m-guihard/biorob_project/README.md

# Design and characterization of a bio-inspired multi-segmented leg consisting of spring and tendon
Contains all files related to the project
