m-guihard/biorob_project/code/README.md

# Running the simulations
All simulations are run from the file 'run.py'. After choosing between the single leg or full quadruped, the options available can be changed.
