m-guihard/biorob_project/CAD/_hip_module.SLDASM

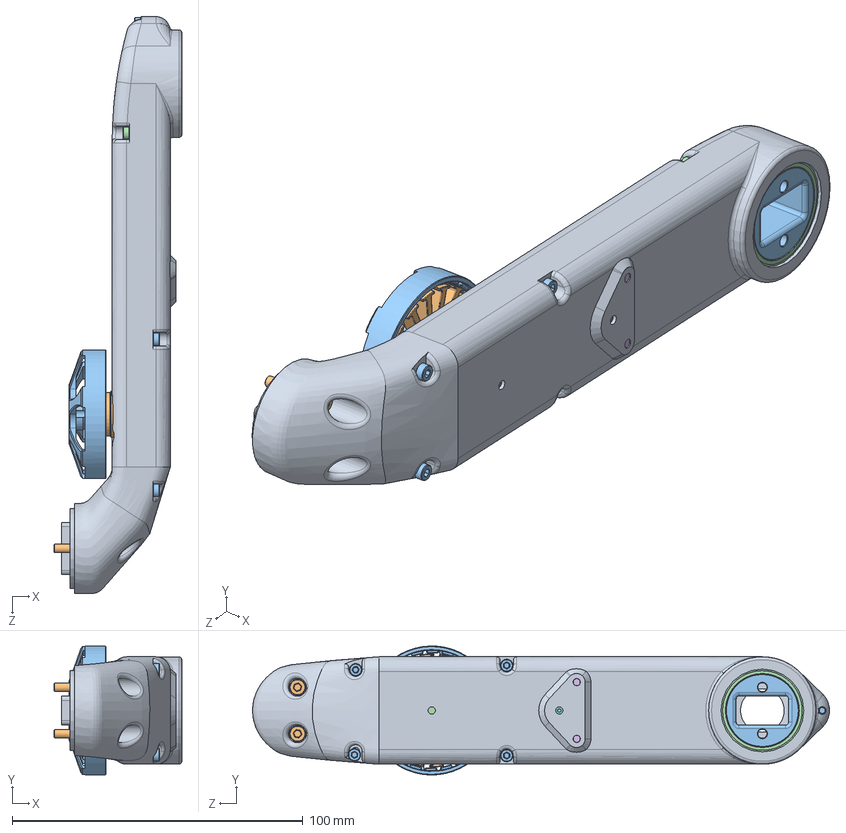
[picture p24: CAD file, 2022-06-10]
CAD/_hip_module.SLDASM
44.0 x 44.4 x 198.6 mm
hip_module_shell
motor_antigravity_4004_stator
motor_antigravity_4004_rotor
motor_antigravity_4004_custom_shaft
motor_antigravity_4004_brass_spacer
transmission_pulley_at3_t10_motor
encoder_codewheel_pwb_mount
encoder_codewheel_5000cpr_pwb_7mm
bearing_8_4_2_sbn_MR84VA x 3
fastener_fhs_m3_5 x 4
transmission_pulley_at3_t30_output
bearing_32_25_4_sbn_61705RS x 2
encoder_avago_aedt_9810
fastener_fhs_m3_16_plastic x 2
transmission_timing_belt_at3_150_4
transmission_pulley_at3_t10_center
transmission_pulley_at3_t30_center
fastener_shcs_m3_16 x 2
fastener_shcs_m2.5_6 x 5
fastener_shcs_m2.5_10 x 3
bearing_7_3_3_sbn_683_2ZVA x 2
fastener_fhs_m3_10 x 2
fastener_washer_m2.5 x 2
transmission_belt_tensioner_roller x 2
transmission_timing_belt_at3_201_6
