m-guihard/biorob_project/CAD/simple_design/_body_structure.SLDASM

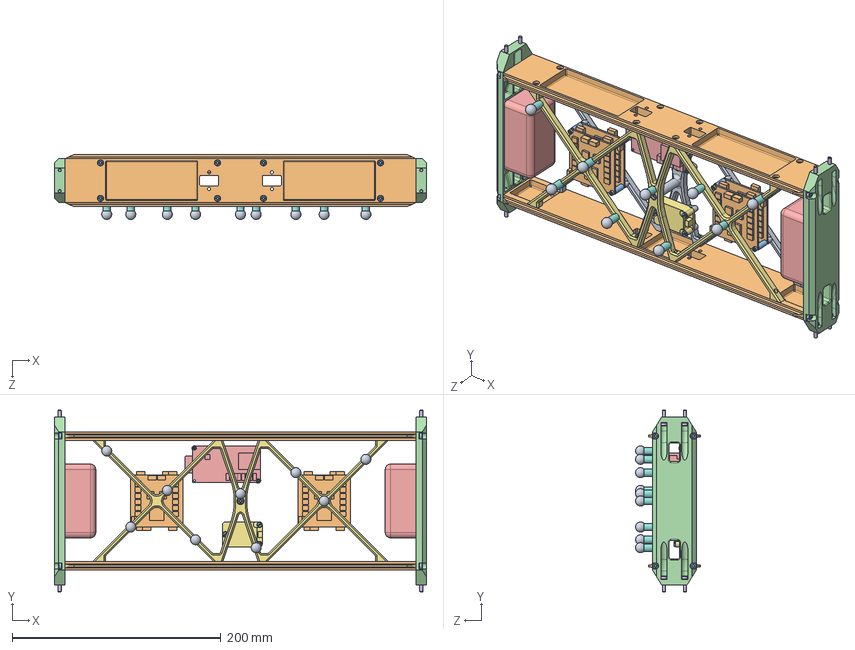
[picture p26: CAD file, 2022-06-10]
CAD/simple_design/_body_structure.SLDASM
356.0 x 174.0 x 62.2 mm
body_structure_bottom
body_structure_side x 2
fastener_shcs_m3_8 x 26
body_structure_front x 2
battery_placeholder x 2
fastener_shcs_m3_12 x 8
body_structure_top
body_structure_top_vicon
vicon_marker_10mm x 9
micro_driver_90_deg_hirose x 4
spacer_micro_driver_stack_12mm x 8
fastener_shcs_m2.5_20 x 8
master_board
fastener_shcs_m2_6 x 3
imu_3dm_cx5_25
fastener_shs_m2.5_12 x 3
