m-guihard/biorob_project/CAD/simple_design/front_right_leg.SLDASM

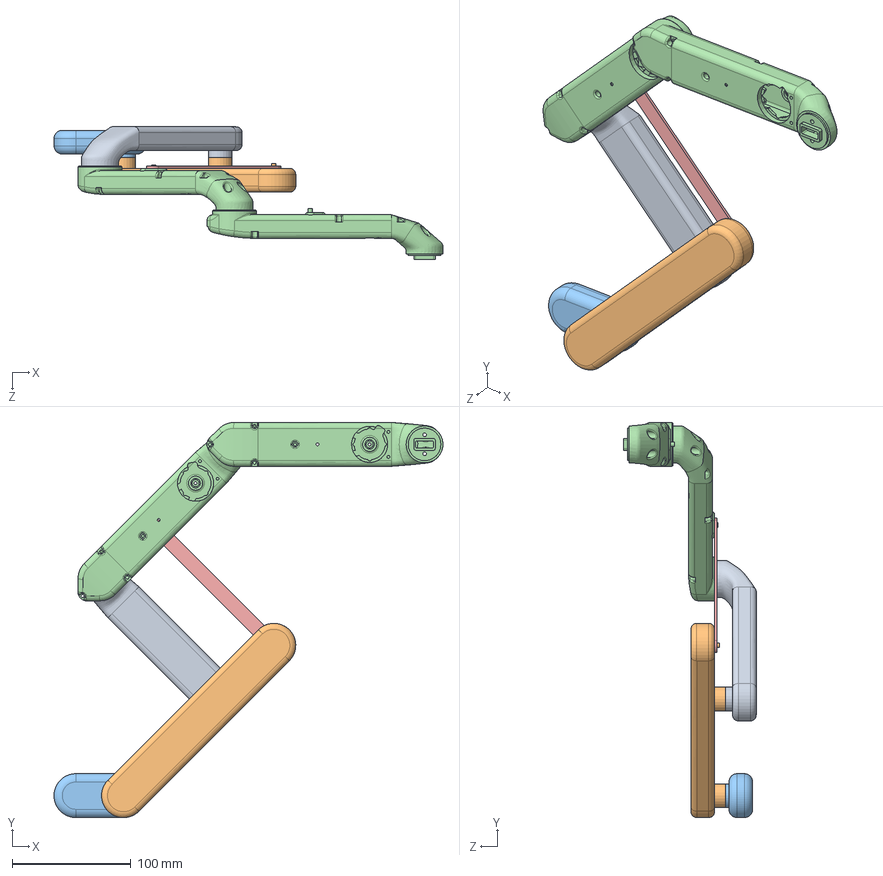
[picture p27: CAD file, 2022-06-10]
CAD/simple_design/front_right_leg.SLDASM
327.3 x 332.6 x 111.5 mm
calf_new
foot_new
toe
upper_leg_module_shell x 2
rod_full
