m-guihard/biorob_project/CAD/simple_design/rod_full.SLDPRT

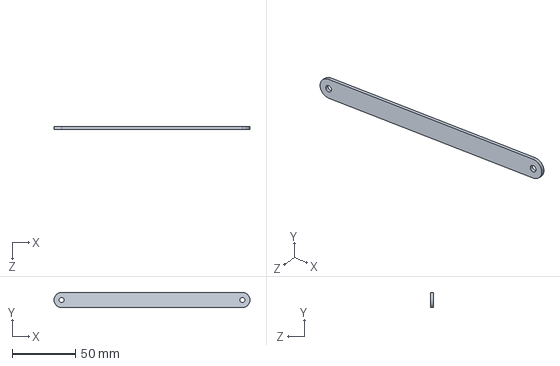
[picture p28: CAD file, 2022-06-10]
CAD/simple_design/rod_full.SLDPRT
155.0 x 12.0 x 2.00 mm
