m-guihard/biorob_project/CAD/simple_design/back_left_leg.SLDASM

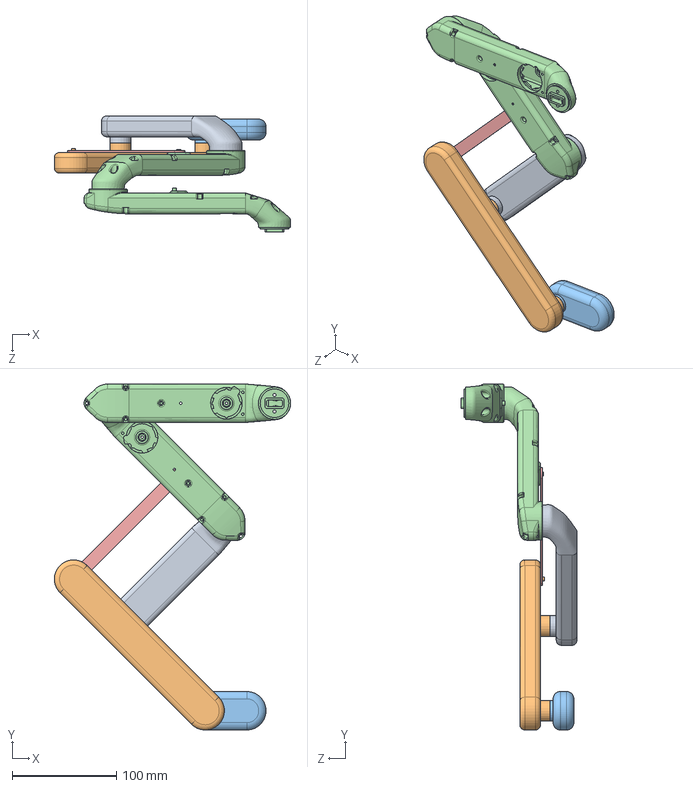
[picture p29: CAD file, 2022-06-10]
CAD/simple_design/back_left_leg.SLDASM
227.1 x 332.6 x 111.5 mm
calf_new
foot_new
toe
upper_leg_module_shell x 2
rod_full
