m-guihard/biorob_project/CAD/detailed_design/assembly.SLDASM

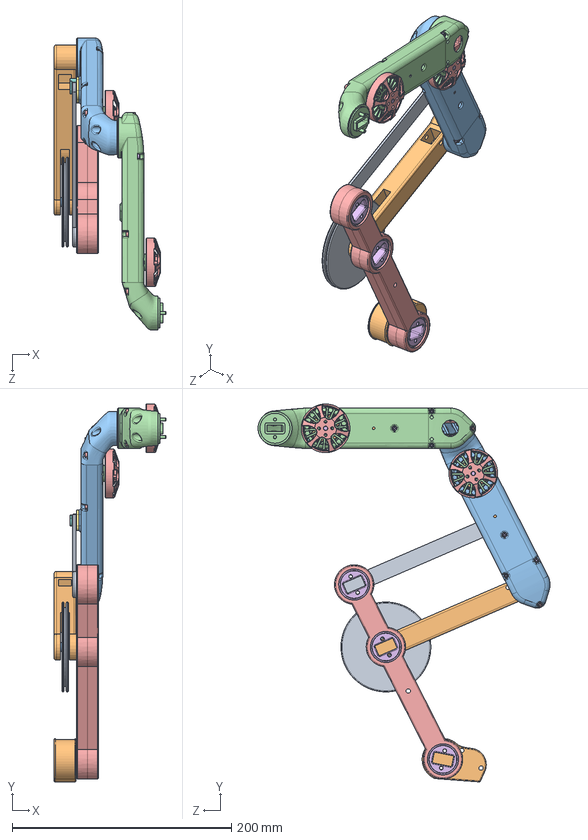
[picture p30: CAD file, 2022-06-10]
CAD/detailed_design/assembly.SLDASM
101.9 x 344.9 x 266.4 mm
pulley_knee
calf
upper_leg_module_shell
motor_antigravity_4004_stator x 2
motor_antigravity_4004_rotor x 2
motor_antigravity_4004_custom_shaft x 2
motor_antigravity_4004_brass_spacer x 2
transmission_pulley_at3_t10_motor x 2
encoder_codewheel_pwb_mount x 2
encoder_codewheel_5000cpr_pwb_7mm x 2
bearing_8_4_2_sbn_MR84VA x 6
fastener_fhs_m3_5 x 8
transmission_pulley_at3_t30_output x 2
bearing_32_25_4_sbn_61705RS x 8
encoder_avago_aedt_9810 x 2
fastener_fhs_m3_16_plastic x 4
transmission_timing_belt_at3_150_4 x 2
transmission_pulley_at3_t10_center x 2
transmission_pulley_at3_t30_center x 2
fastener_shcs_m3_16 x 4
fastener_shcs_m2.5_6 x 10
fastener_shcs_m2.5_10 x 6
bearing_7_3_3_sbn_683_2ZVA x 4
fastener_fhs_m3_10 x 4
fastener_washer_m2.5 x 4
transmission_belt_tensioner_roller x 4
transmission_timing_belt_at3_201_6 x 2
hip_module_shell
foot x 2
rotor x 3
support_bot
support_top
rod
toe
pin_knee_pulley
