m-guihard/biorob_project/CAD/detailed_design/calf.SLDPRT

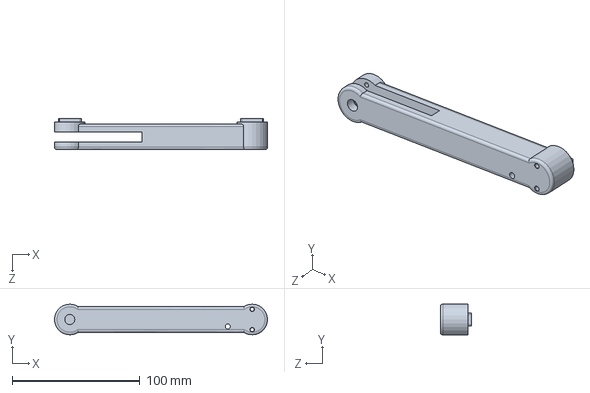
[picture p31: CAD file, 2022-06-10]
CAD/detailed_design/calf.SLDPRT
167.0 x 24.0 x 24.5 mm
