m-guihard/biorob_project/CAD/simple_design/foot_new.SLDPRT

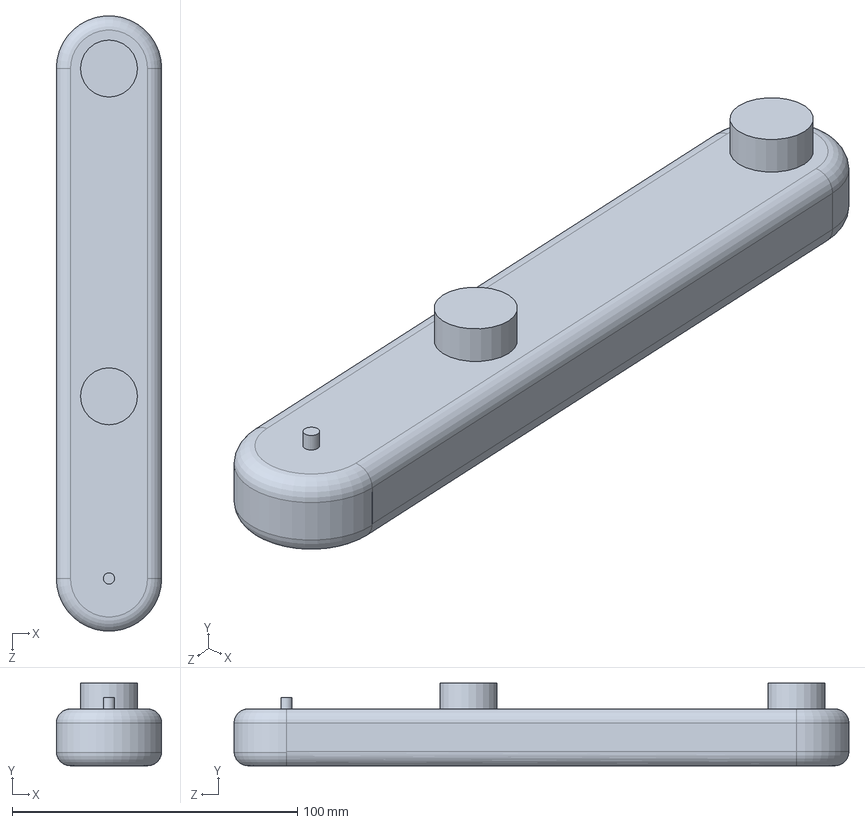
[picture p32: CAD file, 2022-06-10]
CAD/simple_design/foot_new.SLDPRT
37.0 x 29.0 x 215.8 mm
