m-guihard/biorob_project/code/models/biorob_full/meshes/BL_thigh.STL

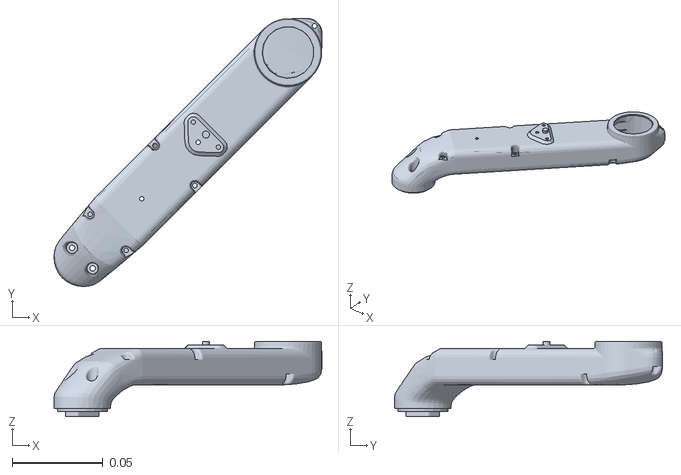
[picture p33: CAD file, 2022-06-10]
code/models/biorob_full/meshes/BL_thigh.STL
0.147 x 0.147 x 0.0415
