m-guihard/biorob_project/code/models/biorob_single/meshes/foot.STL

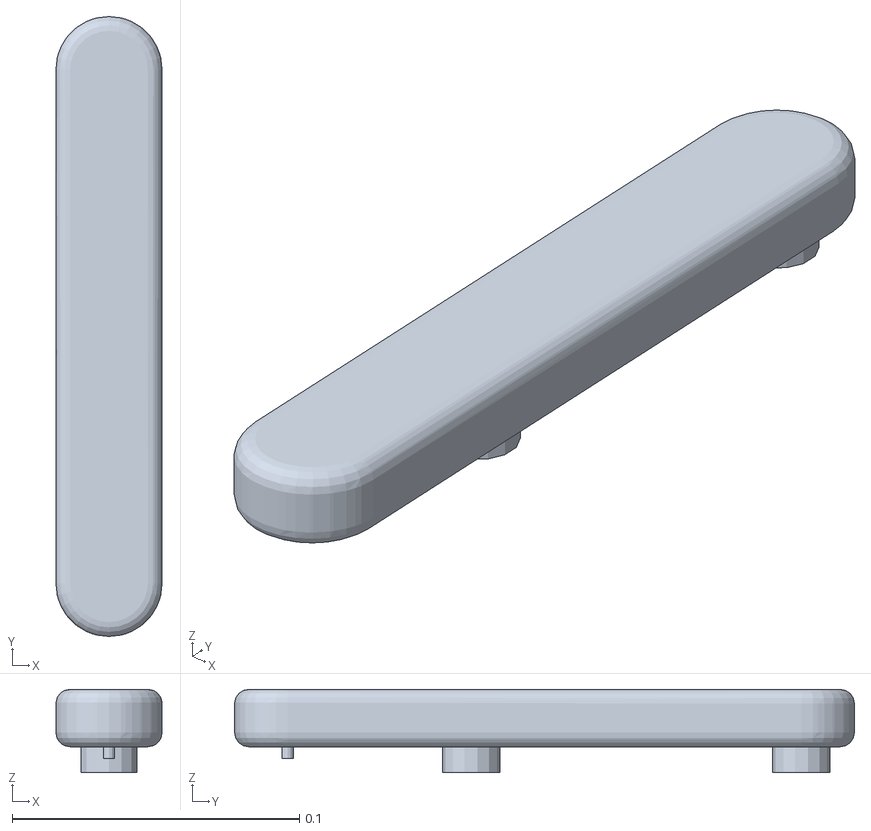
[picture p34: CAD file, 2022-06-10]
code/models/biorob_single/meshes/foot.STL
0.037 x 0.216 x 0.029
