m-guihard/biorob_project/CAD/detailed_design/rotor.SLDPRT

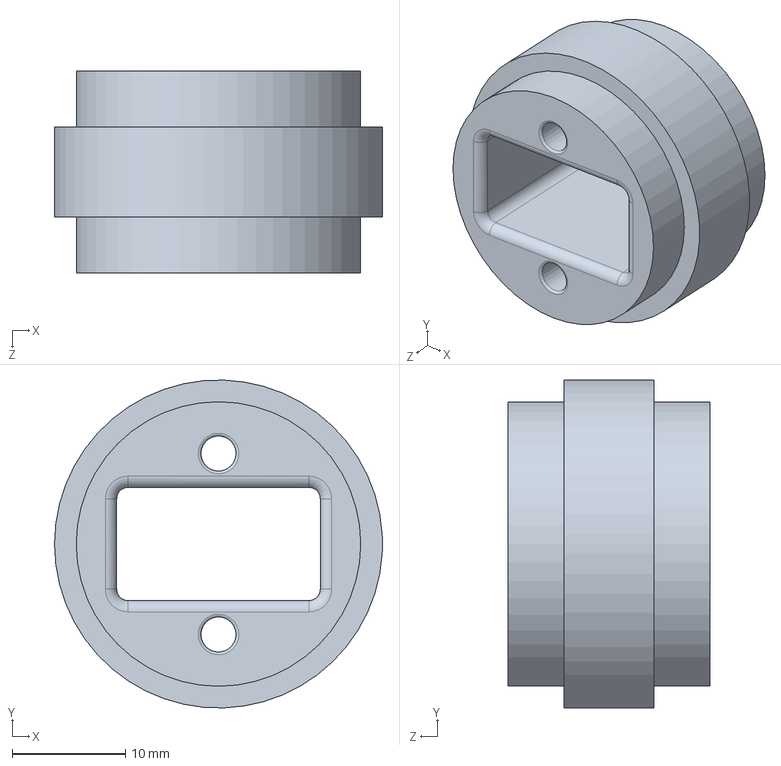
[picture p35: CAD file, 2022-06-10]
CAD/detailed_design/rotor.SLDPRT
29.0 x 29.0 x 17.9 mm
