m-guihard/biorob_project/CAD/simple_design/rod_attachment.SLDPRT

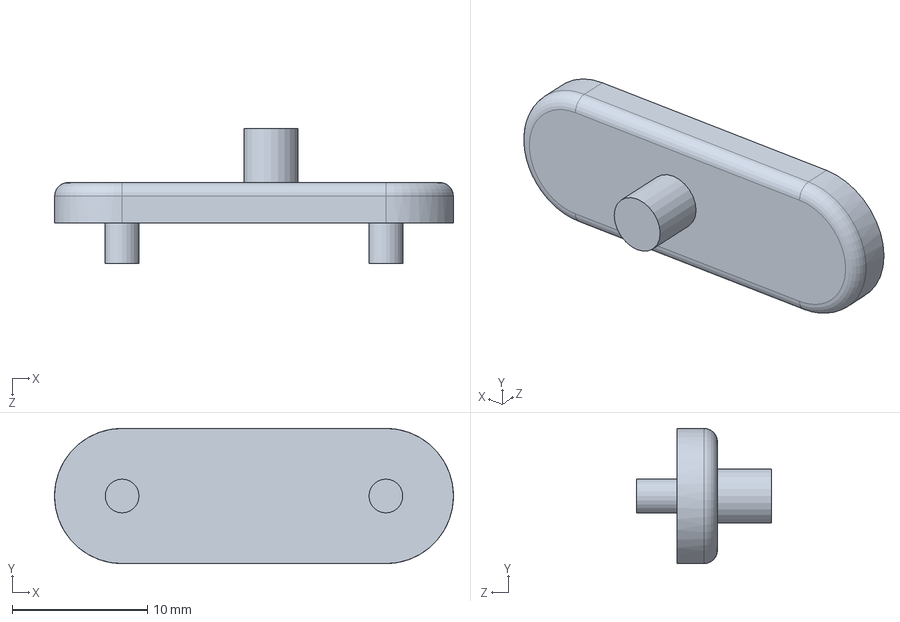
[picture p36: CAD file, 2022-06-10]
CAD/simple_design/rod_attachment.SLDPRT
29.5 x 10.0 x 10.0 mm
