m-guihard/biorob_project/code/models/biorob_full/meshes/FL_rod.STL

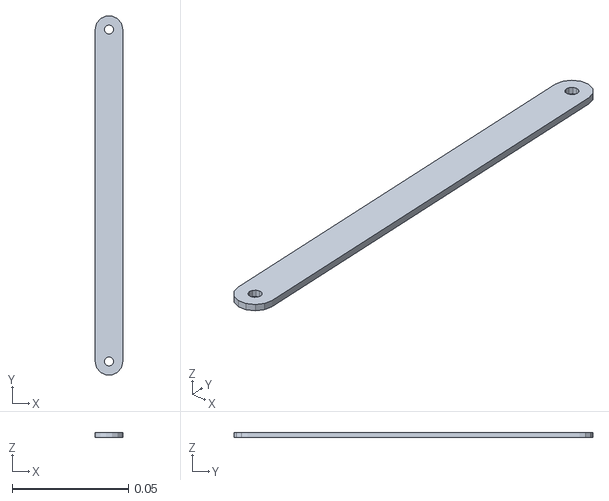
[picture p37: CAD file, 2022-06-10]
code/models/biorob_full/meshes/FL_rod.STL
0.012 x 0.155 x 0.002
