m-guihard/biorob_project/CAD/detailed_design/toe.SLDPRT

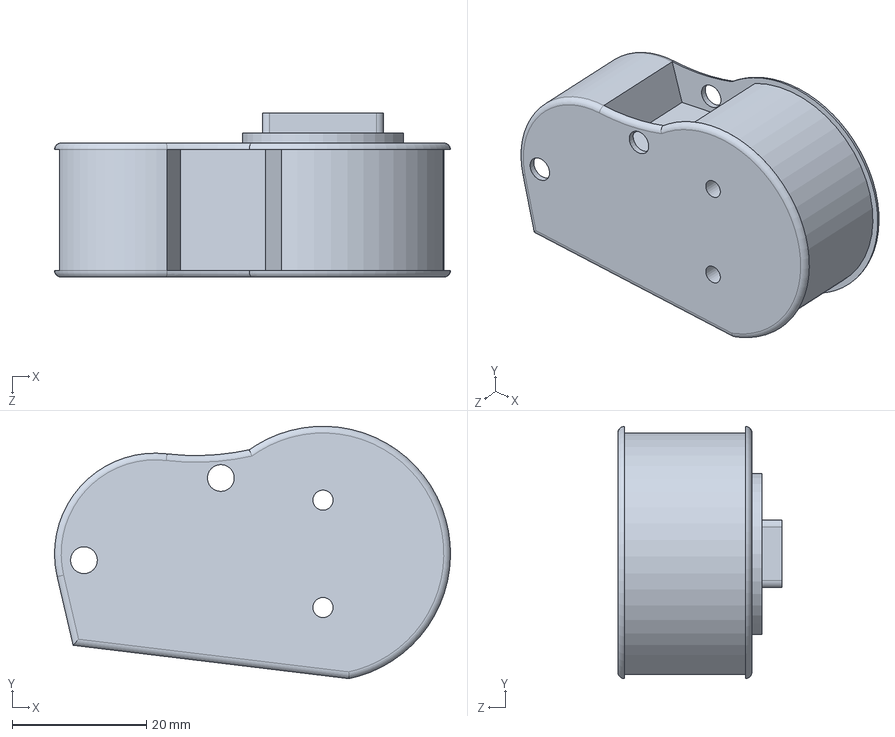
[picture p38: CAD file, 2022-06-10]
CAD/detailed_design/toe.SLDPRT
59.0 x 37.6 x 24.5 mm
