m-guihard/biorob_project/CAD/detailed_design/pulley_knee.SLDPRT

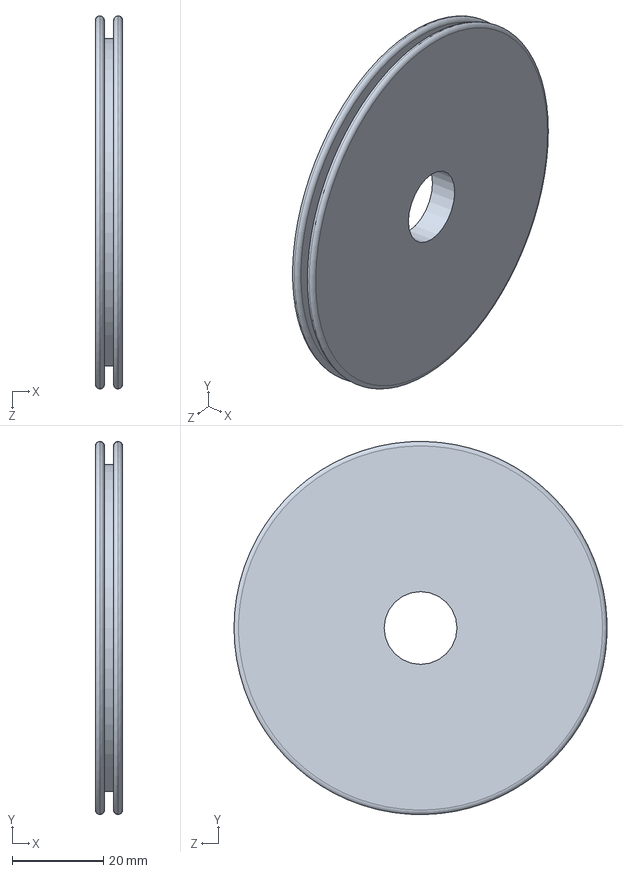
[picture p39: CAD file, 2022-06-10]
CAD/detailed_design/pulley_knee.SLDPRT
6.00 x 82.0 x 82.0 mm
