m-guihard/biorob_project/code/models/biorob_single/meshes/body.STL

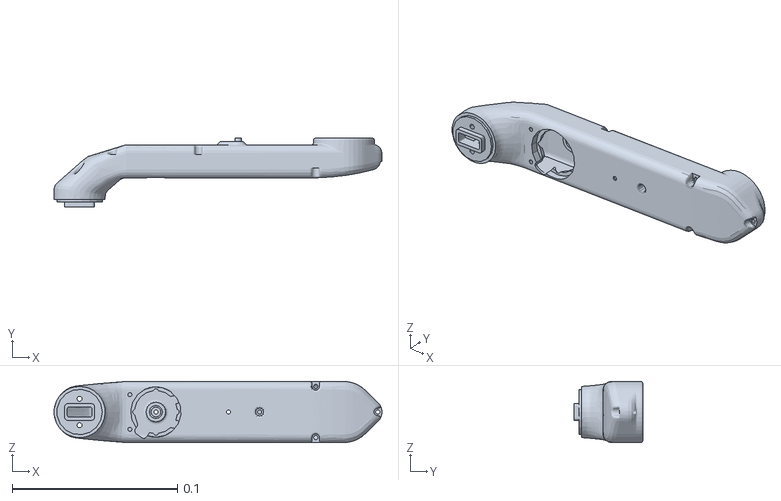
[picture p40: CAD file, 2022-06-10]
code/models/biorob_single/meshes/body.STL
0.199 x 0.0415 x 0.037
