m-guihard/biorob_project/CAD/detailed_design/support_top.SLDPRT

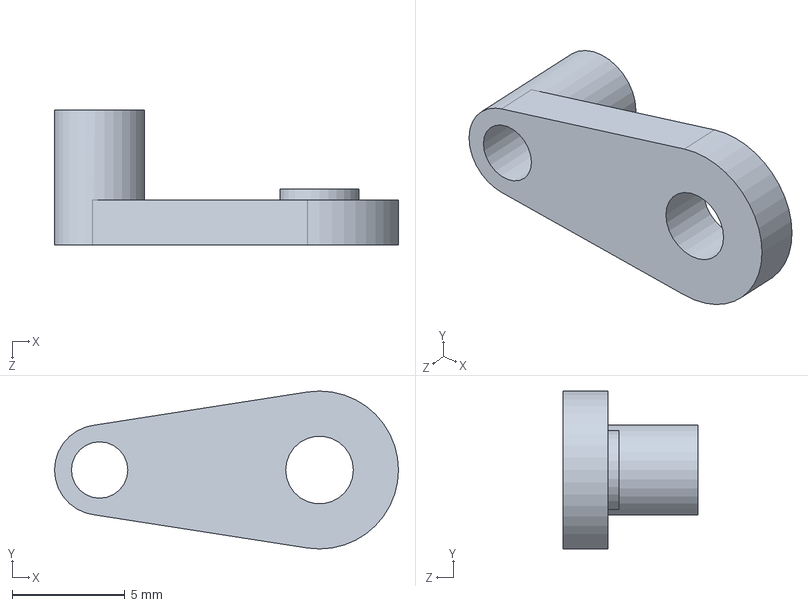
[picture p41: CAD file, 2022-06-10]
CAD/detailed_design/support_top.SLDPRT
15.2 x 7.00 x 6.00 mm
