m-guihard/biorob_project/code/models/biorob_full/meshes/FL_calf.STL

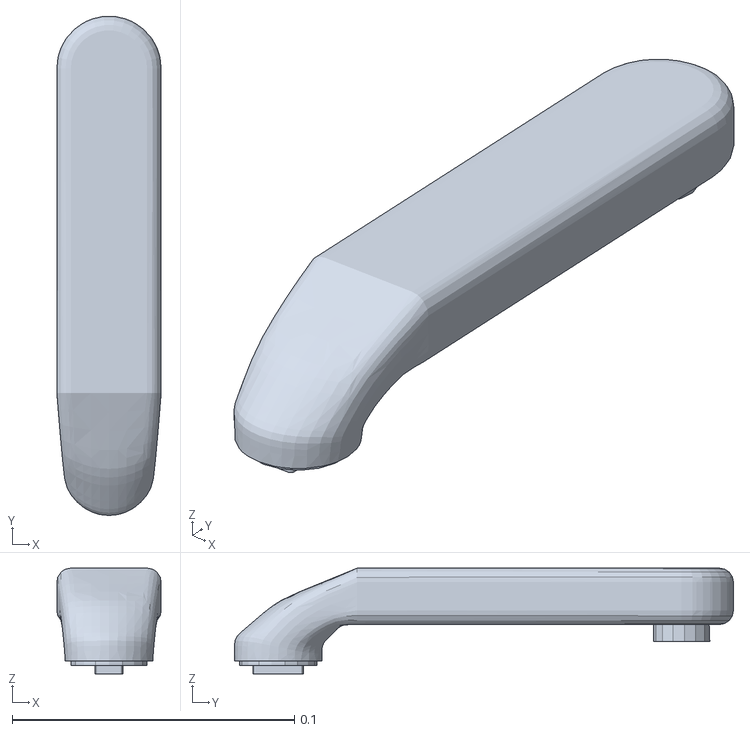
[picture p42: CAD file, 2022-06-10]
code/models/biorob_full/meshes/FL_calf.STL
0.037 x 0.177 x 0.0375
