m-guihard/biorob_project/CAD/detailed_design/foot.SLDPRT

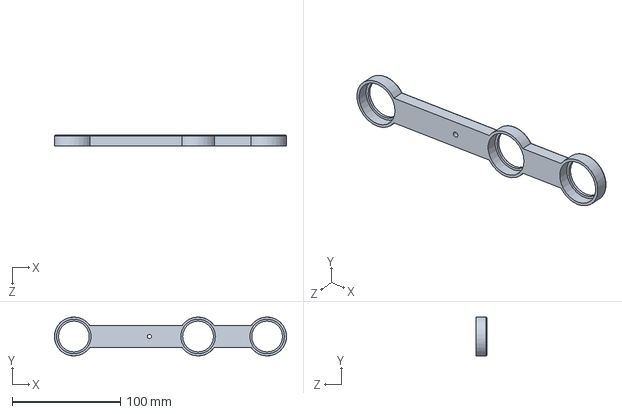
[picture p43: CAD file, 2022-06-10]
CAD/detailed_design/foot.SLDPRT
214.8 x 36.0 x 10.0 mm
