m-guihard/biorob_project/CAD/simple_design/calf_new.SLDPRT

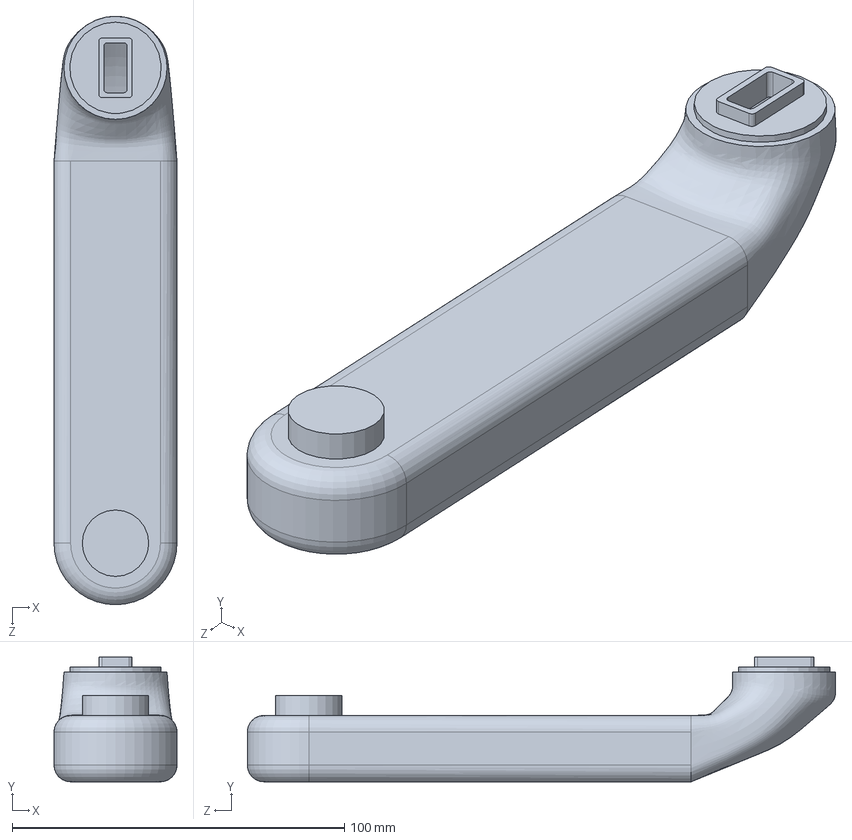
[picture p44: CAD file, 2022-06-10]
CAD/simple_design/calf_new.SLDPRT
37.0 x 37.5 x 177.0 mm
