m-guihard/biorob_project/code/models/biorob_full/meshes/FR_toe.STL

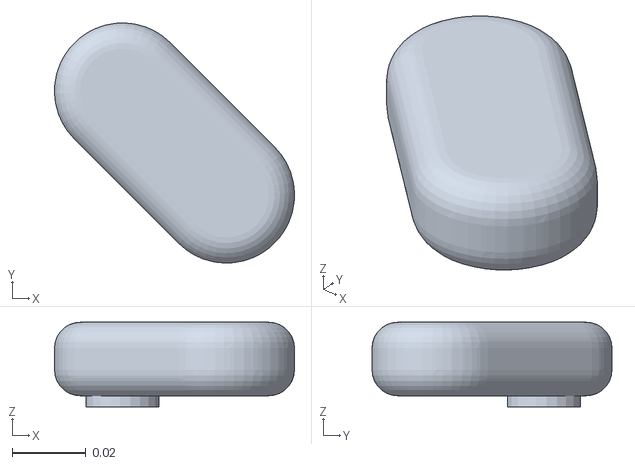
[picture p45: CAD file, 2022-06-10]
code/models/biorob_full/meshes/FR_toe.STL
0.0653 x 0.0653 x 0.023
