m-guihard/biorob_project/code/models/biorob_single/meshes/solo_foot.stl

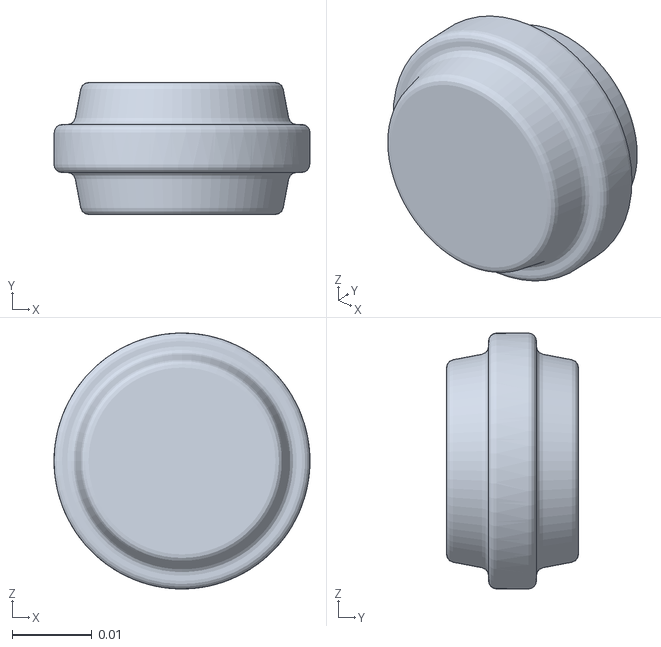
[picture p46: CAD file, 2022-06-10]
code/models/biorob_single/meshes/solo_foot.stl
0.032 x 0.0165 x 0.032
