m-guihard/biorob_project/CAD/detailed_design/rod.SLDPRT

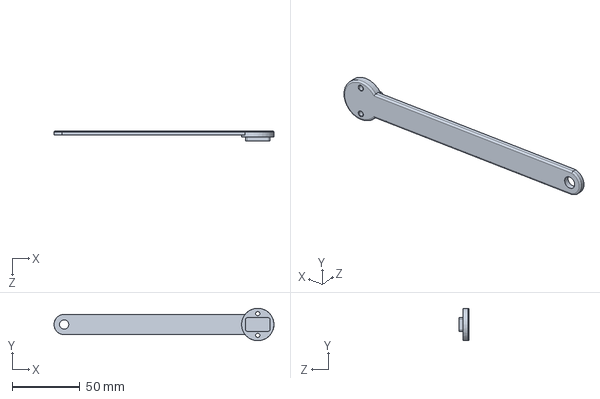
[picture p47: CAD file, 2022-06-10]
CAD/detailed_design/rod.SLDPRT
162.5 x 24.0 x 7.55 mm
