m-guihard/biorob_project/CAD/detailed_design/pin_knee_pulley.SLDPRT

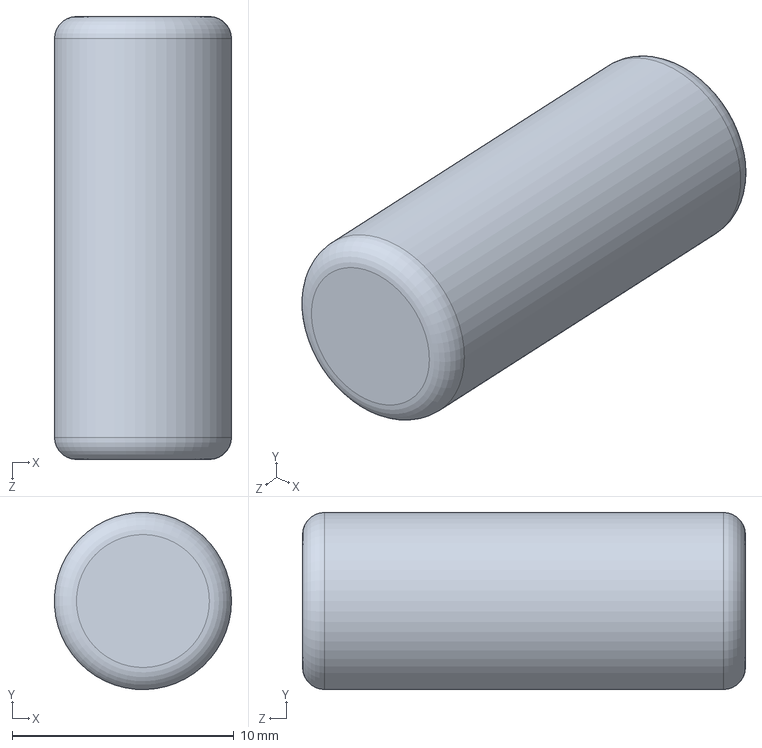
[picture p48: CAD file, 2022-06-10]
CAD/detailed_design/pin_knee_pulley.SLDPRT
7.99 x 8.00 x 20.0 mm
