m-guihard/biorob_project/CAD/simple_design/upper_leg_module_shell.SLDPRT

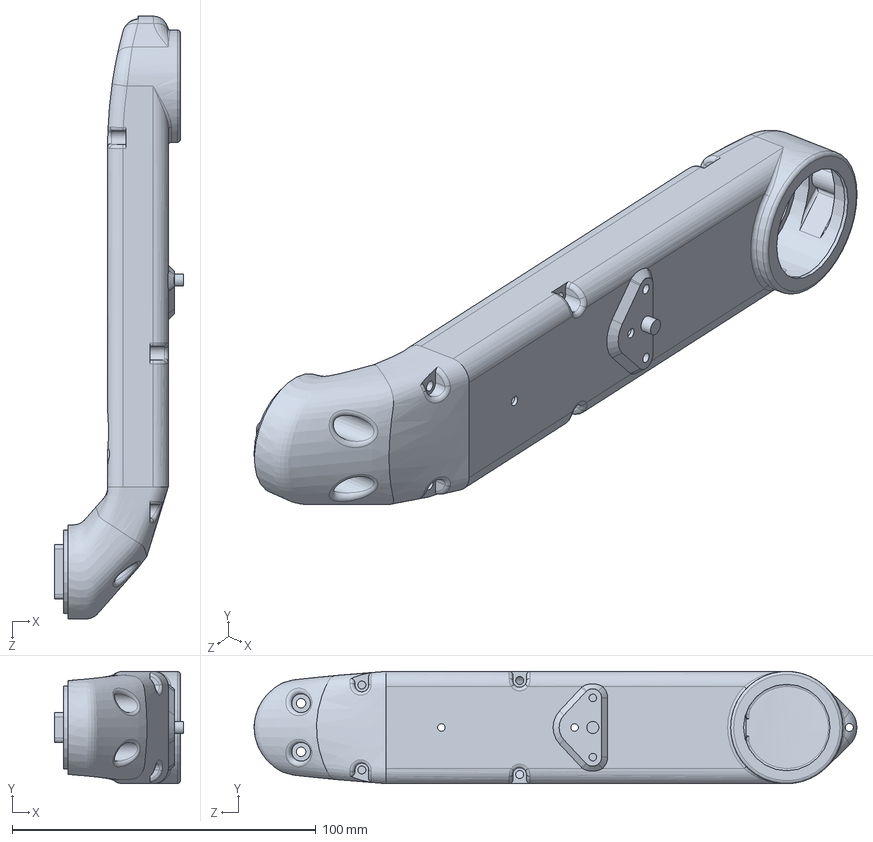
[picture p49: CAD file, 2022-06-10]
CAD/simple_design/upper_leg_module_shell.SLDPRT
42.5 x 37.0 x 198.6 mm
