m-guihard/biorob_project/CAD/detailed_design/support_bot.SLDPRT

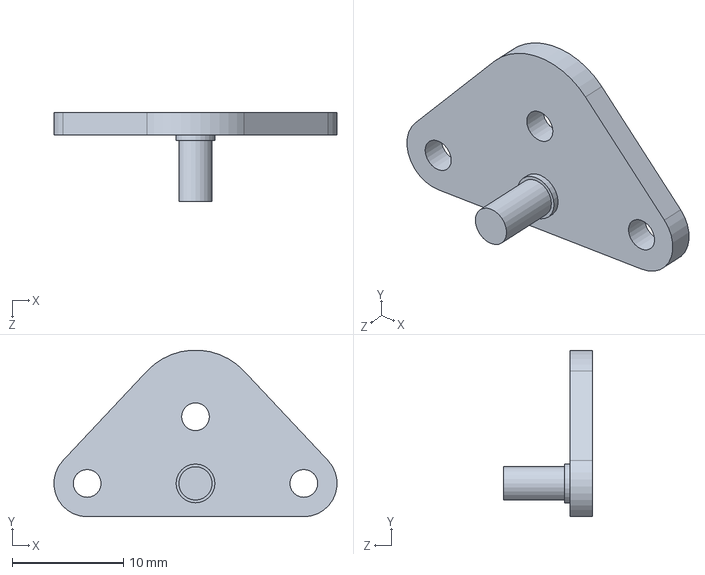
[picture p50: CAD file, 2022-06-10]
CAD/detailed_design/support_bot.SLDPRT
25.5 x 15.0 x 8.00 mm
