m-guihard/biorob_project/CAD/simple_design/toe.SLDPRT

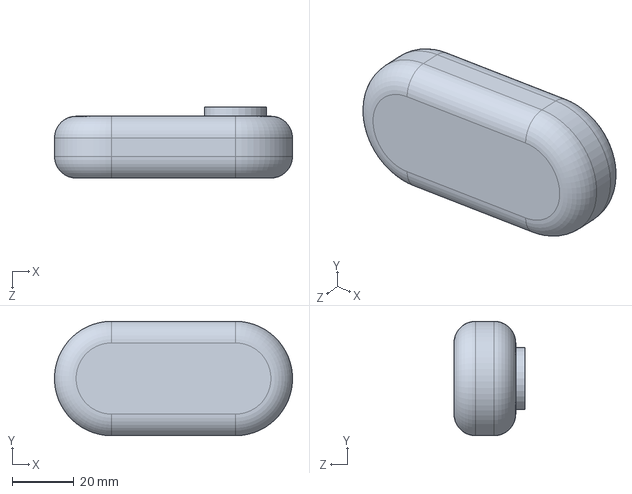
[picture p51: CAD file, 2022-06-10]
CAD/simple_design/toe.SLDPRT
76.9 x 37.0 x 23.0 mm
