m-guihard/biorob_project/code/models/biorob_full/meshes/FR_calf.STL

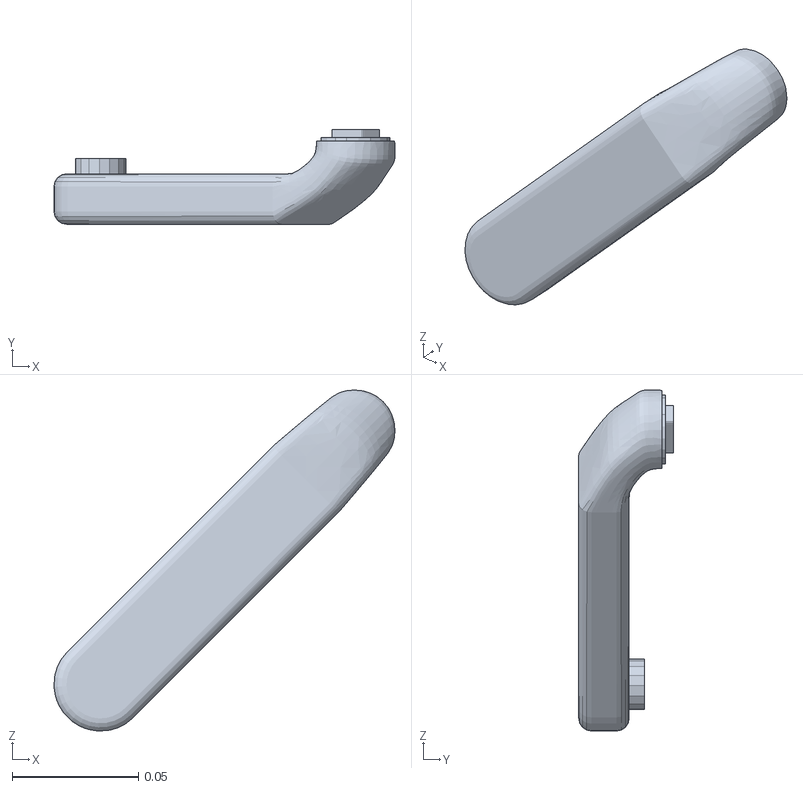
[picture p52: CAD file, 2022-06-10]
code/models/biorob_full/meshes/FR_calf.STL
0.135 x 0.0375 x 0.135
