m-guihard/biorob_project/CAD/simple_design/rod.SLDPRT

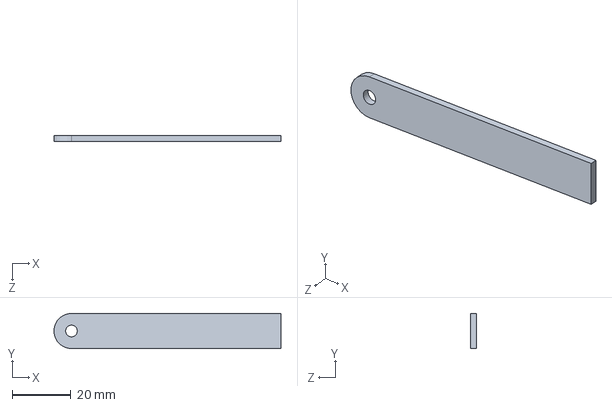
[picture p53: CAD file, 2022-06-10]
CAD/simple_design/rod.SLDPRT
77.5 x 12.0 x 2.00 mm
