m-guihard/biorob_project/(list of files, cad)

Other CAD files:
CAD/simple_design/front_left_leg.SLDASM
CAD/simple_design/back_right_leg.SLDASM
