m-guihard/biorob_project/(commit log)

2022-06-10 Added code
    [BL_.STL, BL_calf.STL, BL_foot.STL, BL_rod.STL, BL_thigh.STL, BL_toe.STL, BR_calf.STL, BR_foot.STL]
2022-06-10 Added CAD files and report
    [_body_structure.SLDASM, _hip_module.SLDASM, _upper_leg_module.SLDASM, assembly.SLDASM, back_left_leg.SLDASM, back_right_leg.SLDASM, calf.SLDPRT, calf_new.SLDPRT]
